Njdor/NJSlowFeeder/CAD_Models/V1.2/Alternate Wheels/slowfeed_wheel_1hole_nj_v1_2.stl

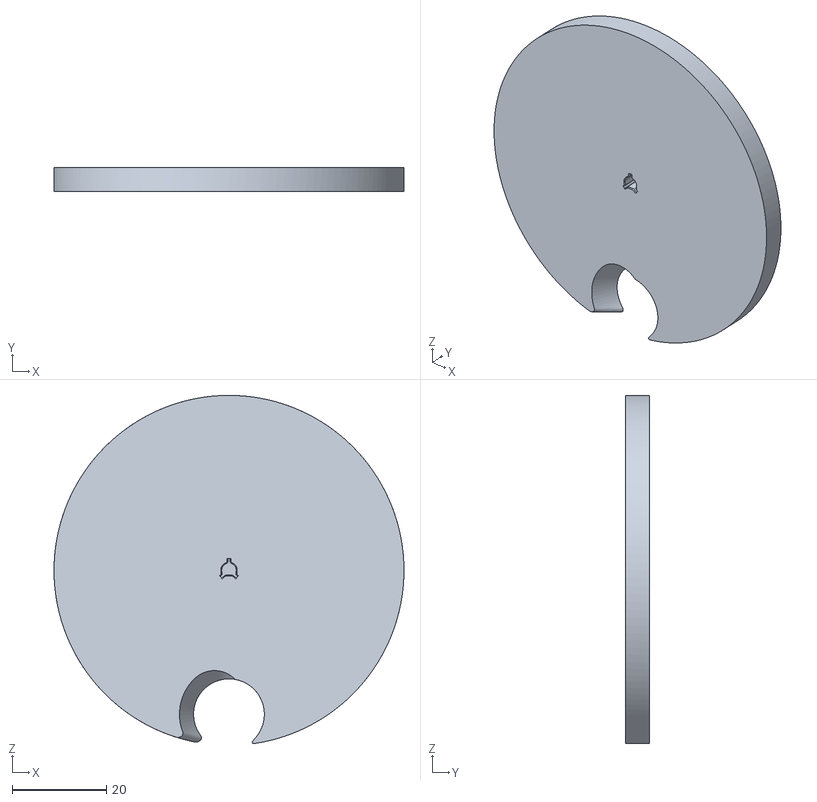
[picture p1: CAD file, 2026-07-26]
CAD_Models/V1.2/Alternate Wheels/slowfeed_wheel_1hole_nj_v1_2.stl
74.2 x 5.00 x 73.8
