Njdor/NJSlowFeeder/CAD_Models/V1.2/Wiring Diagram Xiao-s3-20251222.jpg

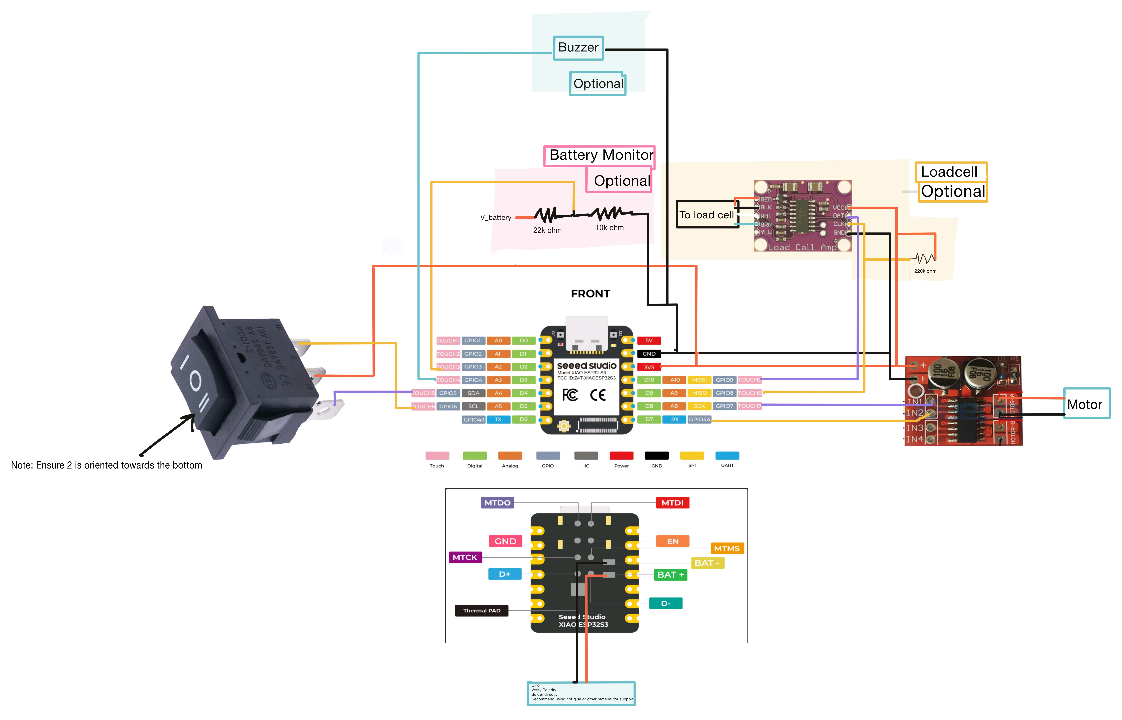
CAD_Models/V1.2/Wiring Diagram Xiao-s3-20251222.jpg
