Njdor/NJSlowFeeder/(threads)

Thread 13 (2025-05-18):

Debug code with Xiao S3

Njdor, 2025-05-18:
Xiao s3 behaviour is different than supermini, validate all functions on xiao.

Njdor, 2025-05-18:
updated pins in code to match GPIOs - digital silkscreen labels don't match GPIO #s

Njdor, 2025-05-18:
Add IN2 pulldown to keep the motor controller in normal operation, on xiao it floated high enough to cause logic issues.

Njdor, 2025-05-18:
Check HX711 function and deep sleep functions. Update sleep pulldowns/pullups.

Closed 2025-06-30.

Thread 20 (2025-08-02):

Motor runs at startup

Njdor, 2025-08-02:
In the current design, the IN2 motor control input is connected to GPIO 44 on the Xiao ESP32-S3. GPIO 44 defaults to output with a pull-up resistor on reset/wake from deep sleep per the ESP32-S3 technical manual.

Short term fix:
motor.setup() has been moved up in the setup loop to run earlier so IN2 is only driven for approximately 0.4-0.5 seconds.

Long-term solutions to this issue are as follows:
1. Move IN2 from Pin 44 to unused GPIO 1, 2 (or 3, 4 if no battery voltage sense/buzzer). NOT GPIO 43 since it is also pulled-up on reset.
2. Do not connect IN2 at all, wire motor so that IN1 drives the correct direction (counter clockwise)
3. Live with it since it's a short pulse and isn't a bad initial wake-up indicator.

Njdor, 2025-08-02:
Technically option 4 is write a custom bootloader but that's not happening lol
