Njdor/NJSlowFeeder/(commit log)

2025-12-23 Correct Wiring Diagram
2026-07-26 1 Hole Wheel, Autostarts wheel on startup if loadcells aren't present.
